matheusbucater/aeropendulo/dados/aeropendulum_step.csv

Time | Theta | Time(s) | Theta(rad)
0 | -3 | 0 | -0.0523598775598299
16 | -3 | 0.016 | -0.0523598775598299
32 | -3 | 0.032 | -0.0523598775598299
48 | -3 | 0.048 | -0.0523598775598299
64 | -3 | 0.064 | -0.0523598775598299
80 | -3 | 0.08 | -0.0523598775598299
96 | -3 | 0.096 | -0.0523598775598299
112 | -3 | 0.112 | -0.0523598775598299
129 | -3 | 0.129 | -0.0523598775598299
145 | -2 | 0.145 | -0.0349065850398866
161 | -2 | 0.161 | -0.0349065850398866
177 | -2 | 0.177 | -0.0349065850398866
193 | -2 | 0.193 | -0.0349065850398866
209 | -1 | 0.209 | -0.0174532925199433
225 | -1 | 0.225 | -0.0174532925199433
241 | -1 | 0.241 | -0.0174532925199433
258 | 0 | 0.258 | 0
274 | 0 | 0.274 | 0
290 | 0 | 0.29 | 0
306 | 0 | 0.306 | 0
322 | 1 | 0.322 | 0.0174532925199433
338 | 1 | 0.338 | 0.0174532925199433
354 | 2 | 0.354 | 0.0349065850398866
370 | 2 | 0.37 | 0.0349065850398866
387 | 3 | 0.387 | 0.0523598775598299
403 | 3 | 0.403 | 0.0523598775598299
419 | 5 | 0.419 | 0.0872664625997165
435 | 5 | 0.435 | 0.0872664625997165
451 | 6 | 0.451 | 0.10471975511966
467 | 7 | 0.467 | 0.122173047639603
483 | 8 | 0.483 | 0.139626340159546
500 | 9 | 0.5 | 0.15707963267949
516 | 10 | 0.516 | 0.174532925199433
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
