matheusbucater/aeropendulo/codigos/read_from_arduino.py

from serial.tools import list_ports
import sys
import serial
import time
import csv

# Identify the correct port
ports = list_ports.comports()
for port in ports: print(port)

file = "data.csv"
if len(sys.argv) == 2:
    file = sys.argv[1]

# Create CSV file
f = open("data.csv","w",newline='')
f.truncate()

# Open the serial com
serialCom = serial.Serial('/dev/ttyACM0', 9600)

# Toggle DTR to reset the Arduino
serialCom.setDTR(False)
time.sleep(1)
serialCom.flushInput()
serialCom.setDTR(True)

# How many data points to record
kmax = 800

# Loop through and collect data as it is available
for k in range(kmax):
    try:
        # Read the line
        s_bytes = serialCom.readline()
        decoded_bytes = s_bytes.decode("utf-8").strip('\r\n')

        # Parse the line
        if k == 0:
            values = decoded_bytes.split(";")
        else:
            values = [float(x) for x in decoded_bytes.split(";")]
        print(values)

        # Write to CSV
        writer = csv.writer(f,delimiter=";")
        writer.writerow(values)

    except:
        print("Error encountered, line was not recorded.")

f.close()
