matheusbucater/aeropendulo/(commit log)

2025-05-09 adiciona codigos
    [aeropendulum.csv, pendulum.csv]
2025-05-09 renomeia images para imagens
2025-05-09 renomeia simulink_sistema_linearizado.png para simulink_sistema_com_entrada.png
2025-05-09 adiciona aeropendulum_step.csv
    [aeropendulum_step.csv]
